huozce/yoloopencvrobot/train29/val_batch2_pred.jpg

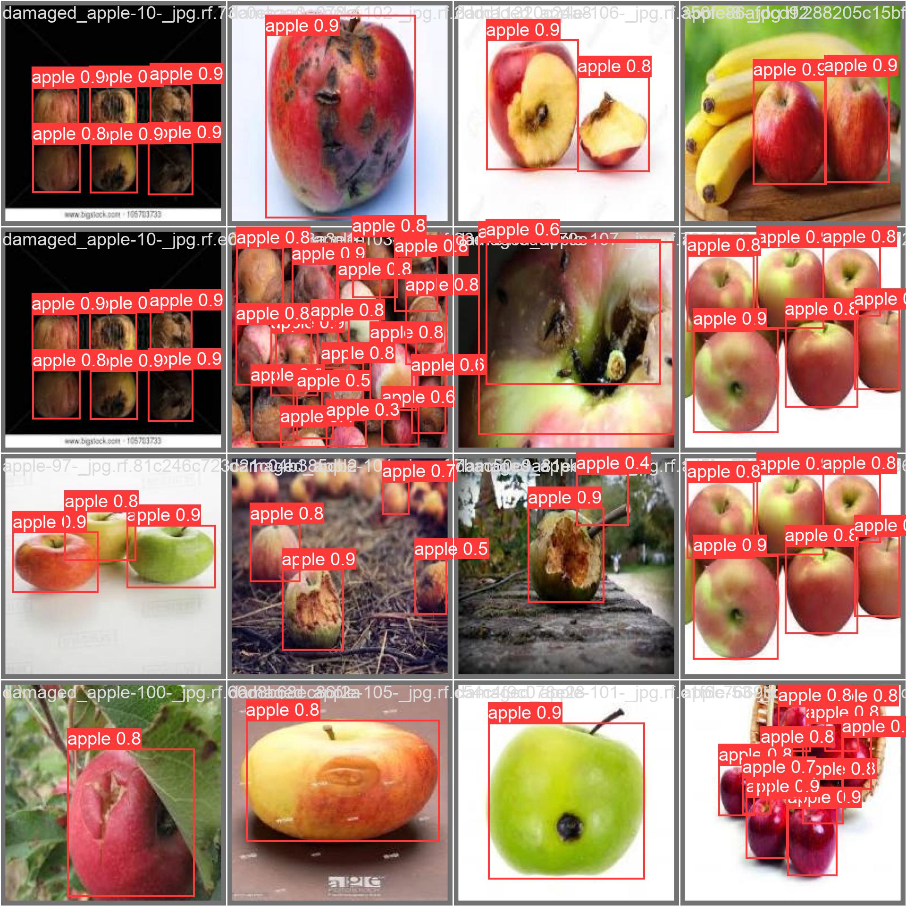
train29/val_batch2_pred.jpg
