huozce/yoloopencvrobot/train29/labels.jpg

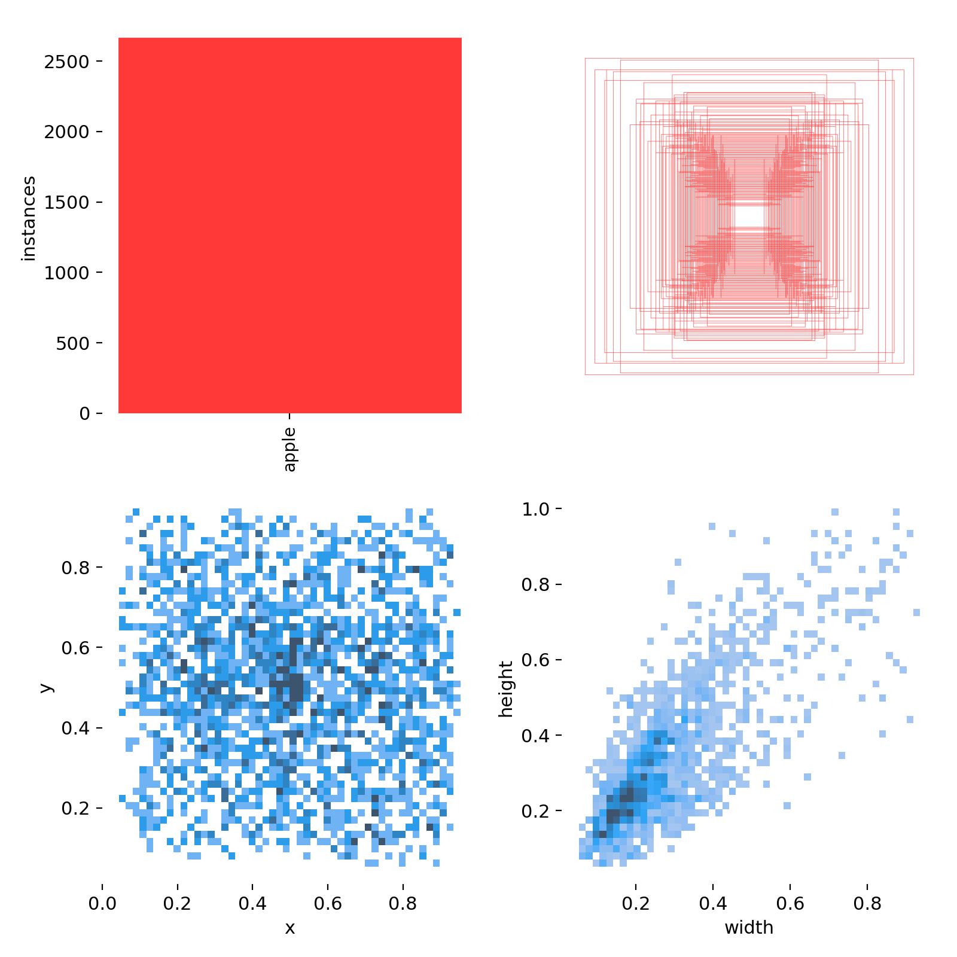
train29/labels.jpg
