huozce/yoloopencvrobot/train29/confusion_matrix.png

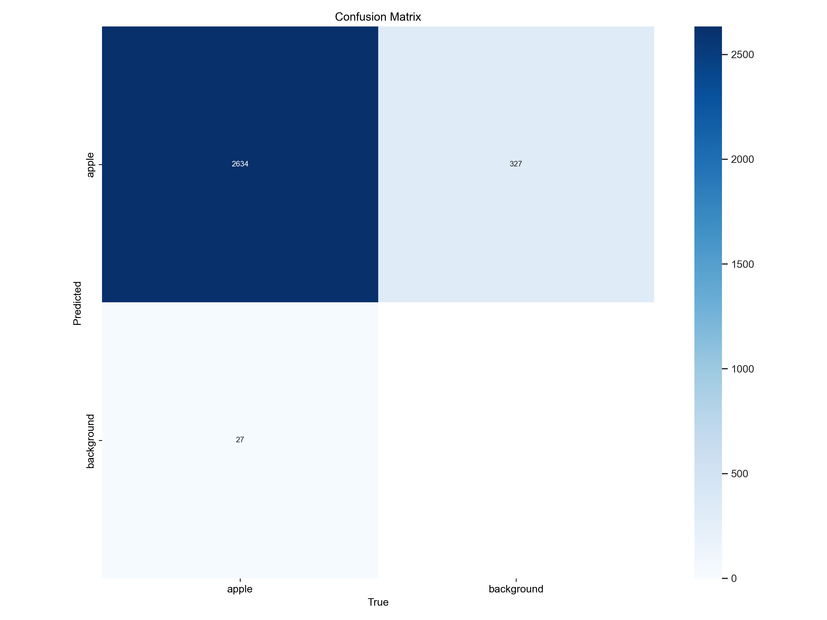
train29/confusion_matrix.png
