huozce/yoloopencvrobot/train29/confusion_matrix_normalized.png

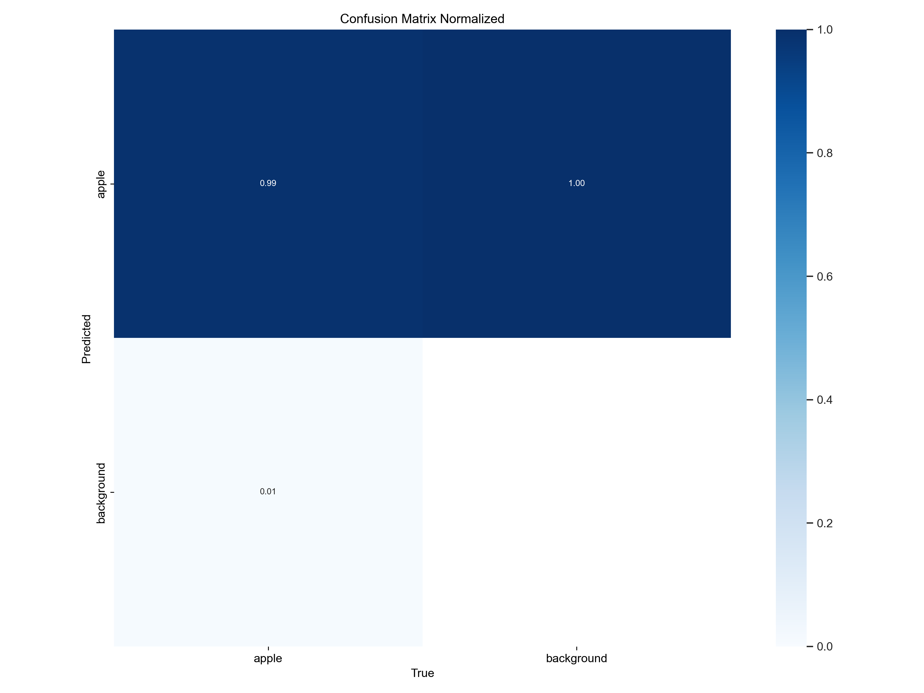
train29/confusion_matrix_normalized.png
