huozce/yoloopencvrobot/train29/F1_curve.png

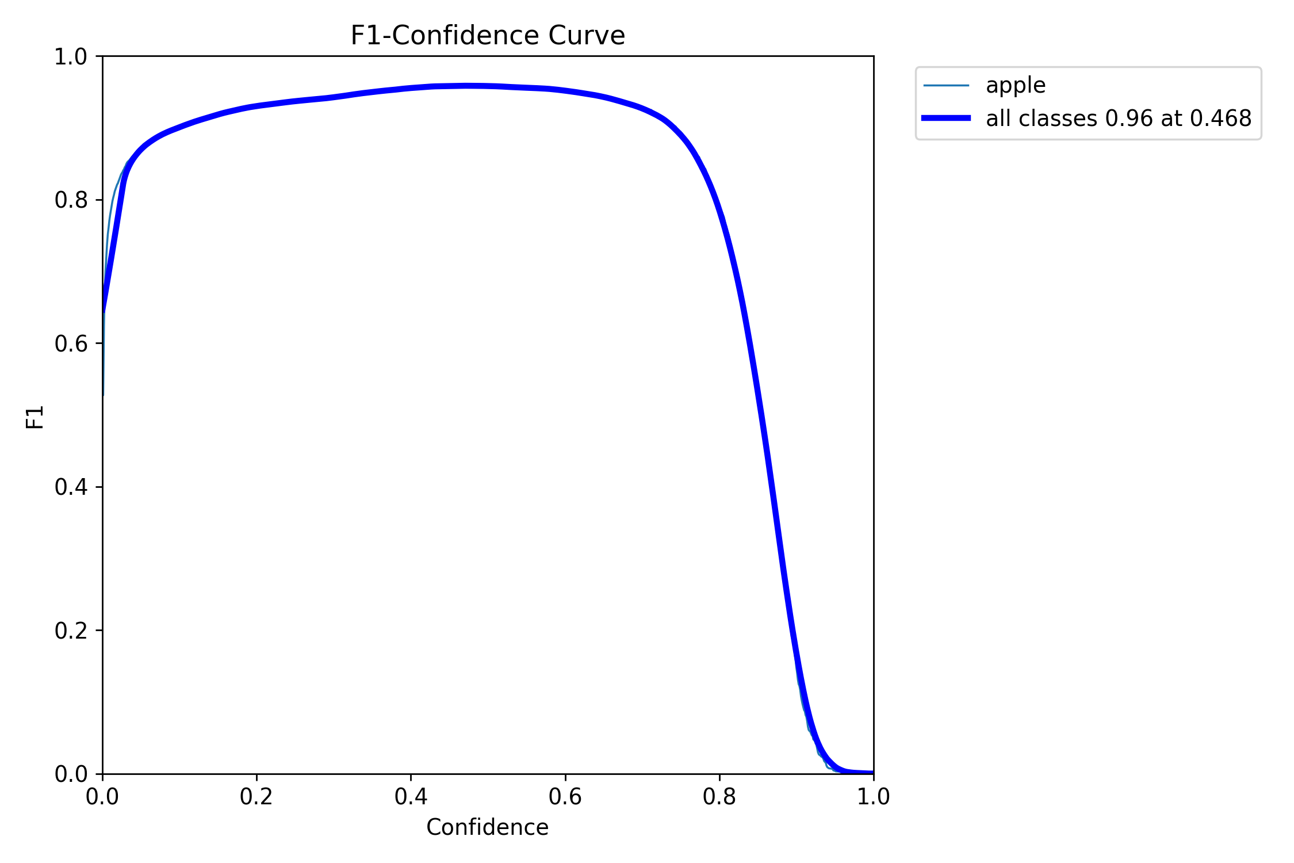
train29/F1_curve.png
