huozce/yoloopencvrobot/train29/labels_correlogram.jpg

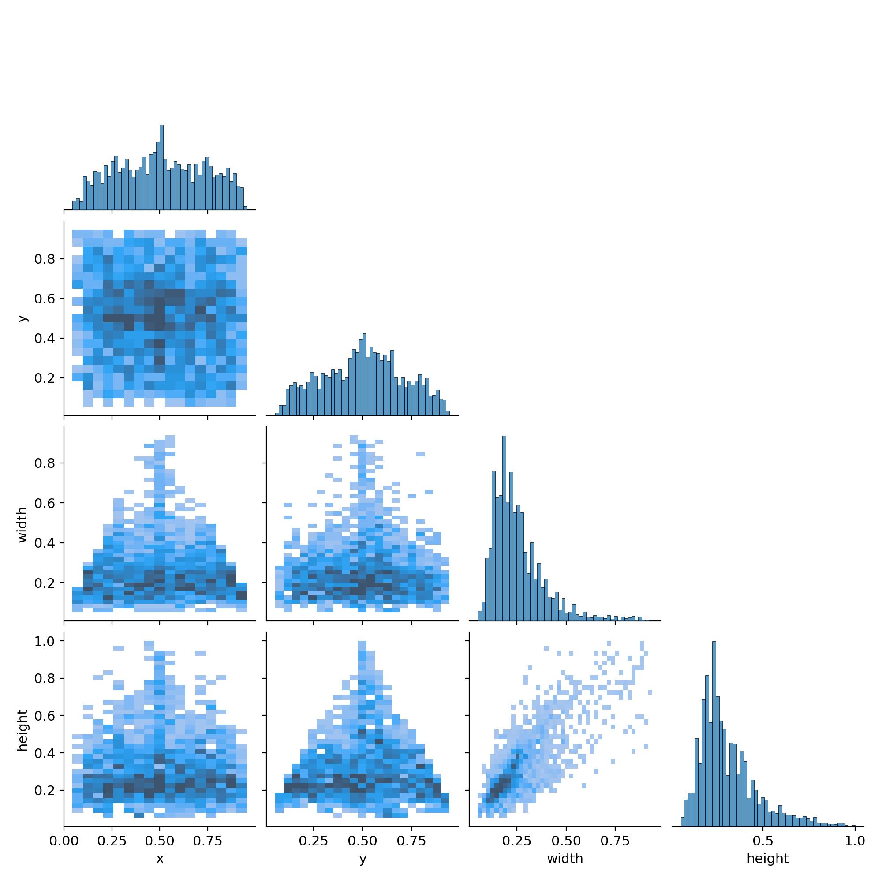
train29/labels_correlogram.jpg
