huozce/yoloopencvrobot/train29/P_curve.png

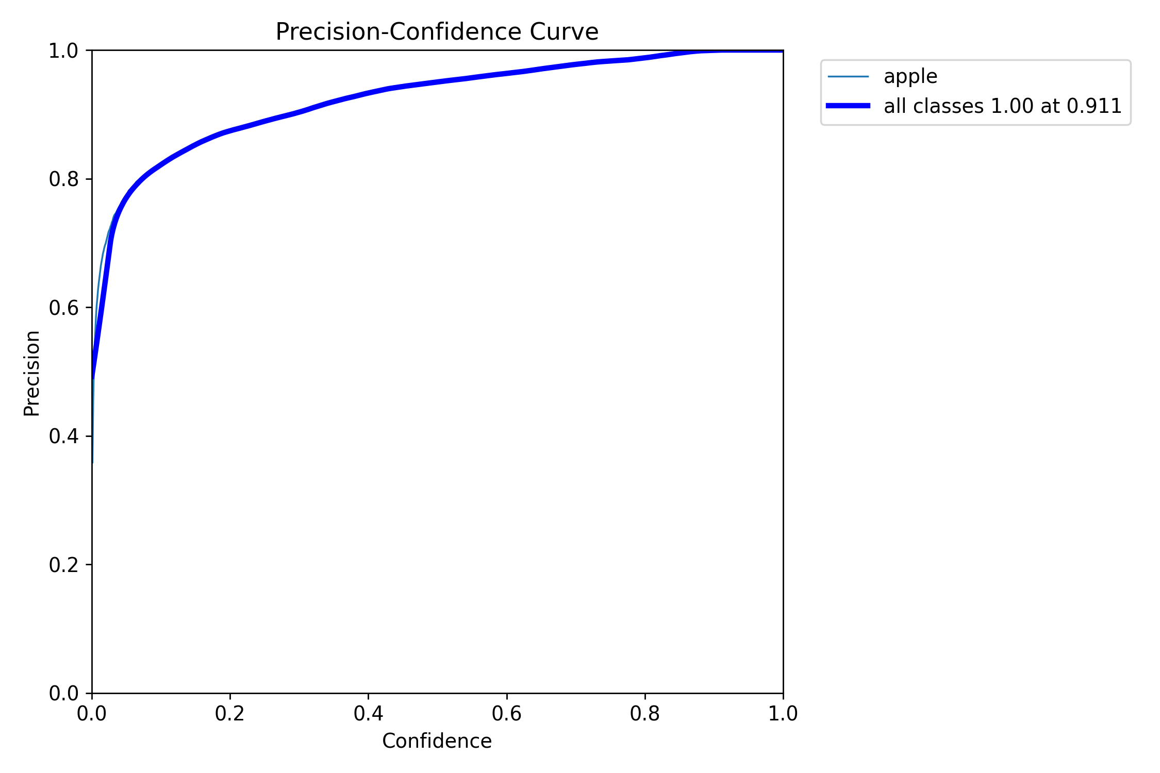
train29/P_curve.png
