huozce/yoloopencvrobot/train29/PR_curve.png

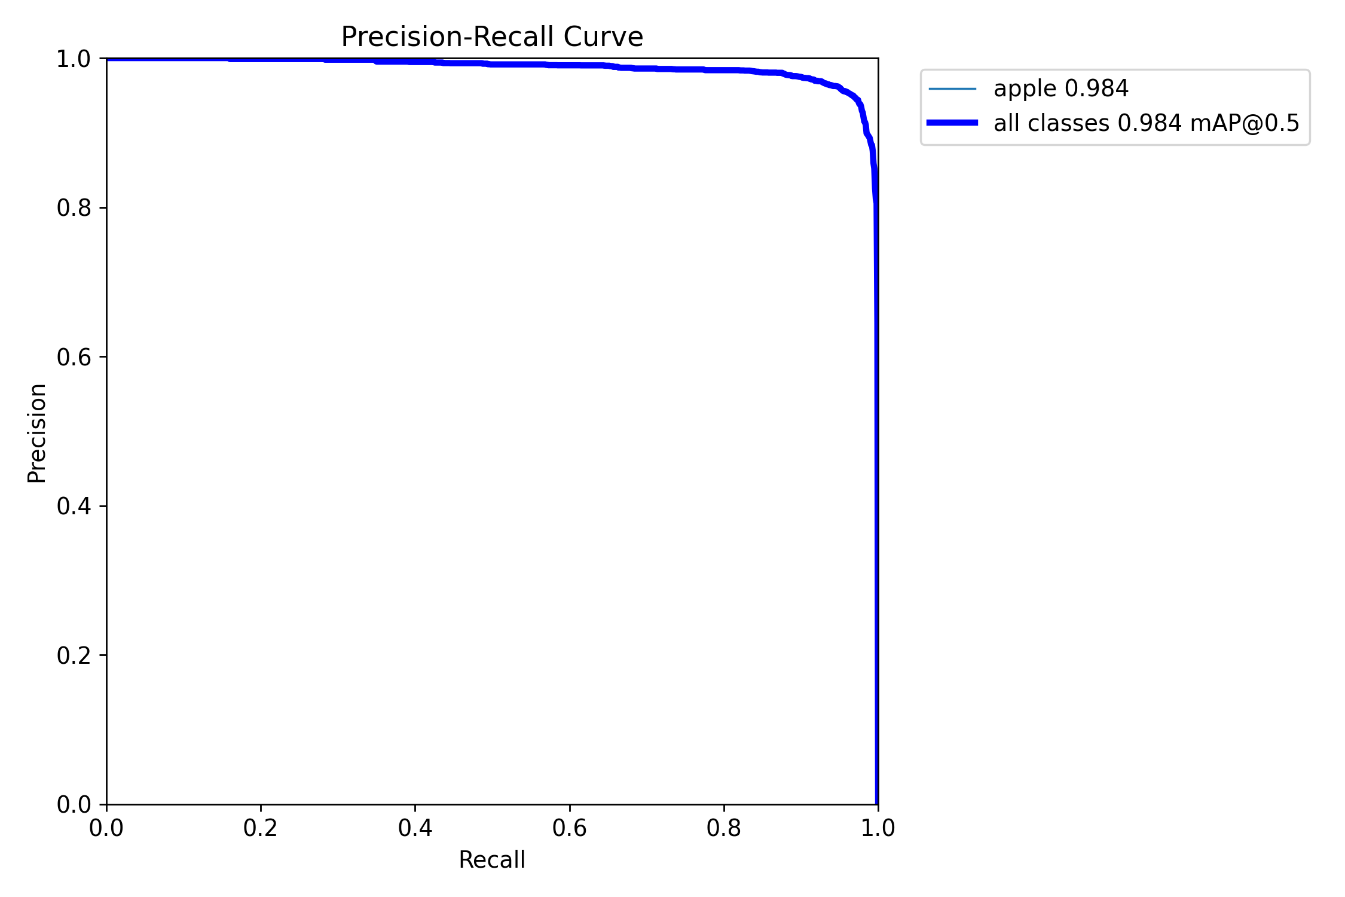
train29/PR_curve.png
