huozce/yoloopencvrobot/train29/train_batch0.jpg

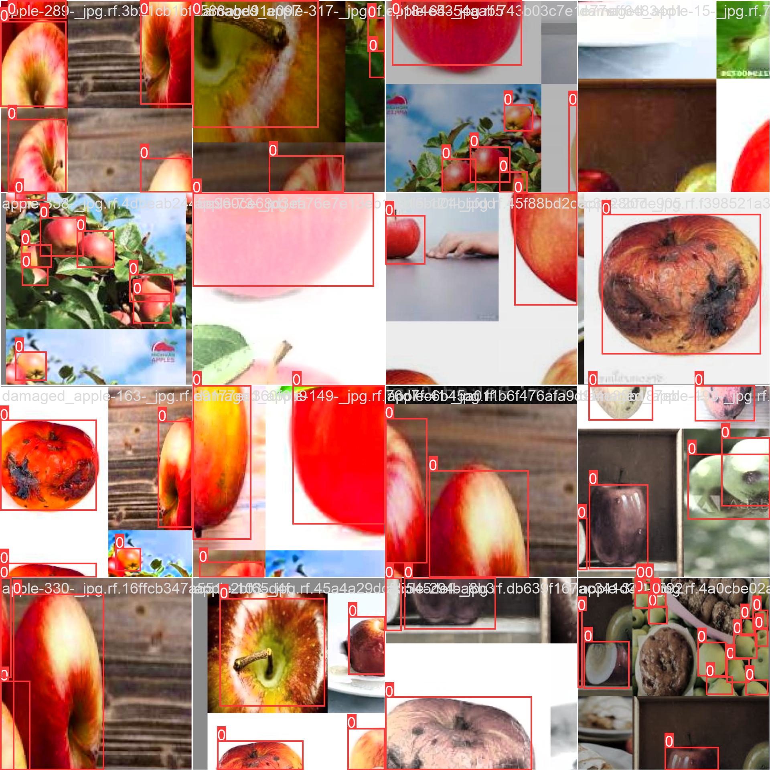
train29/train_batch0.jpg
