huozce/yoloopencvrobot/train29/train_batch1.jpg

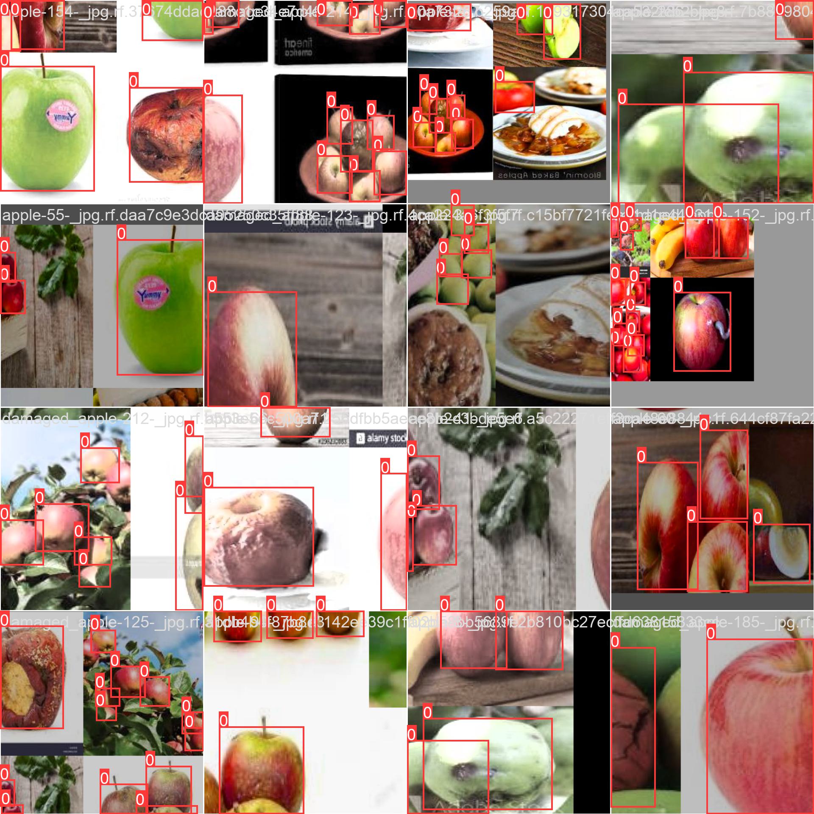
train29/train_batch1.jpg
