huozce/yoloopencvrobot/train29/train_batch2.jpg

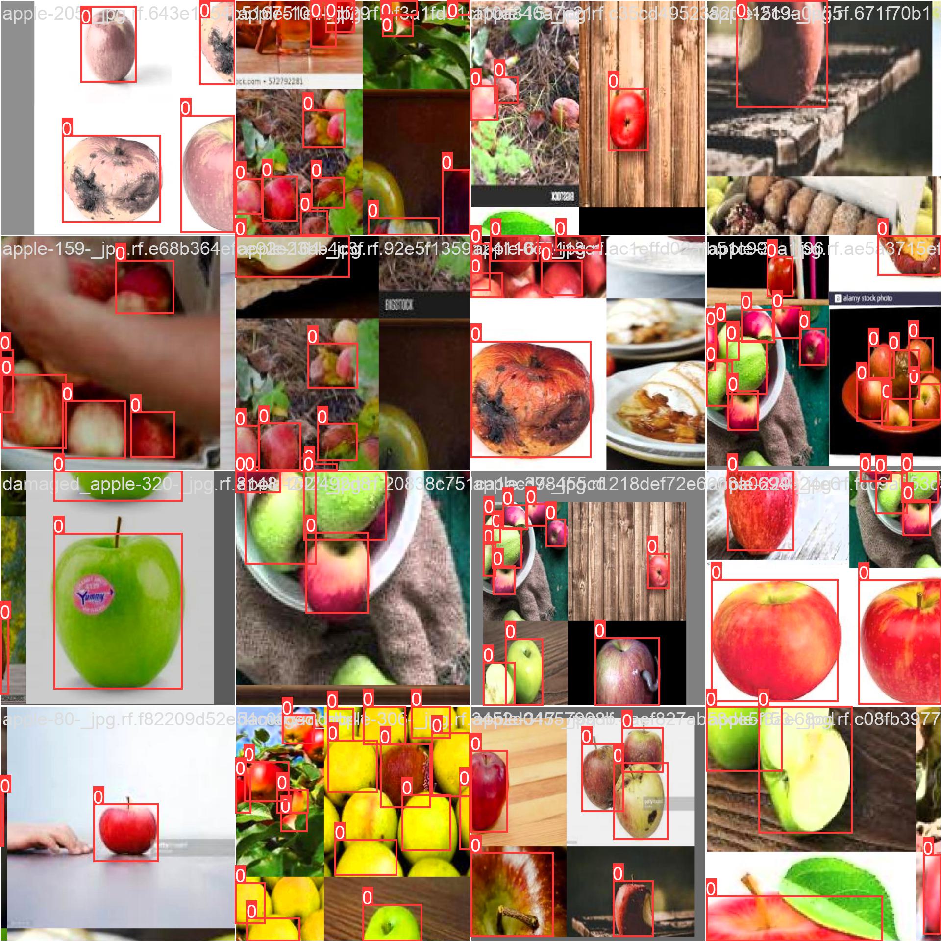
train29/train_batch2.jpg
