huozce/yoloopencvrobot/train29/train_batch5600.jpg

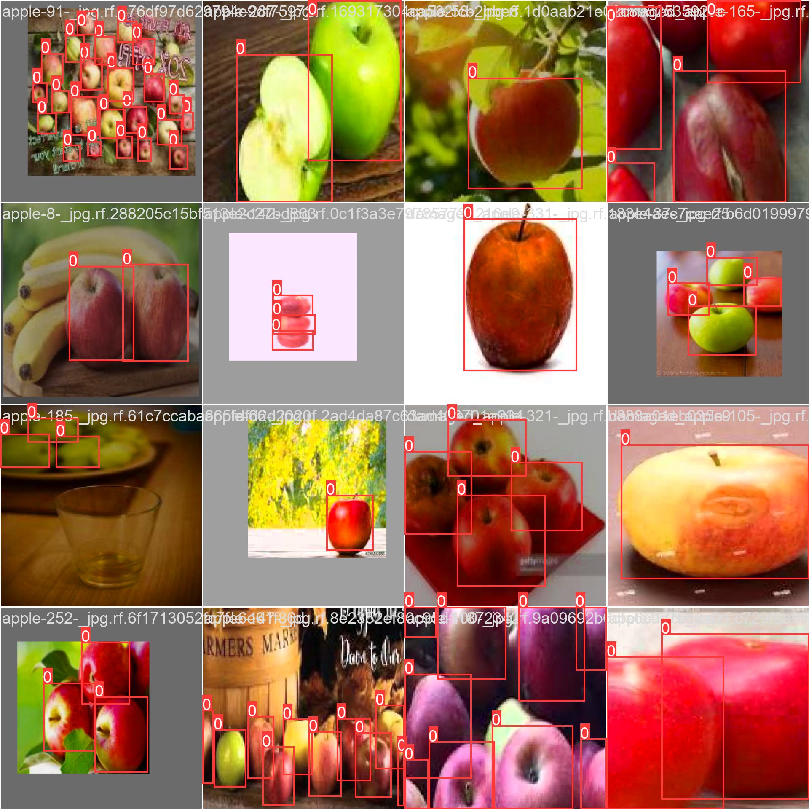
train29/train_batch5600.jpg
