huozce/yoloopencvrobot/train29/train_batch5601.jpg

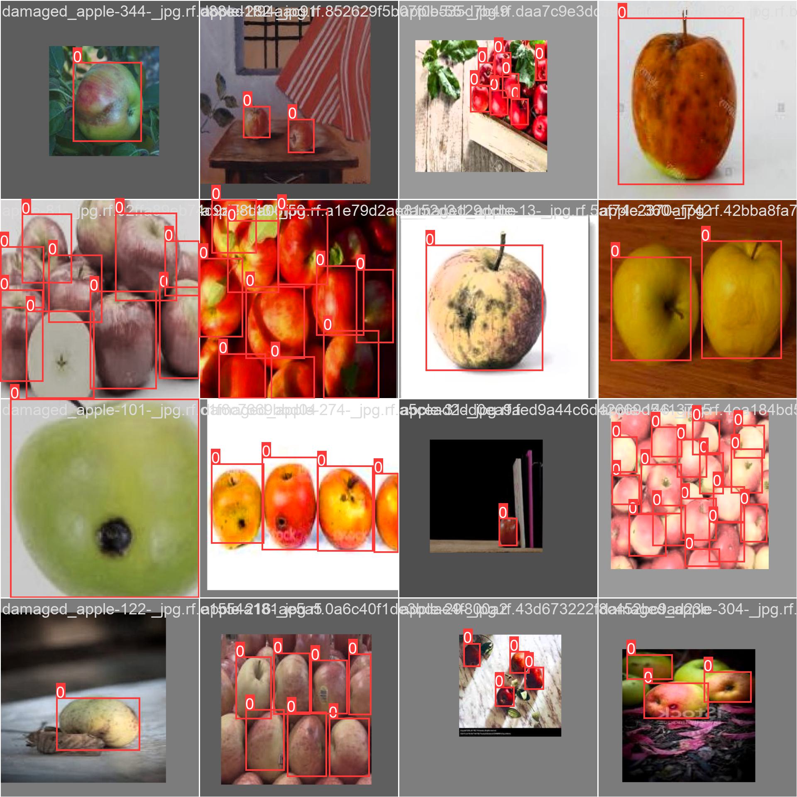
train29/train_batch5601.jpg
