huozce/yoloopencvrobot/train29/train_batch5602.jpg

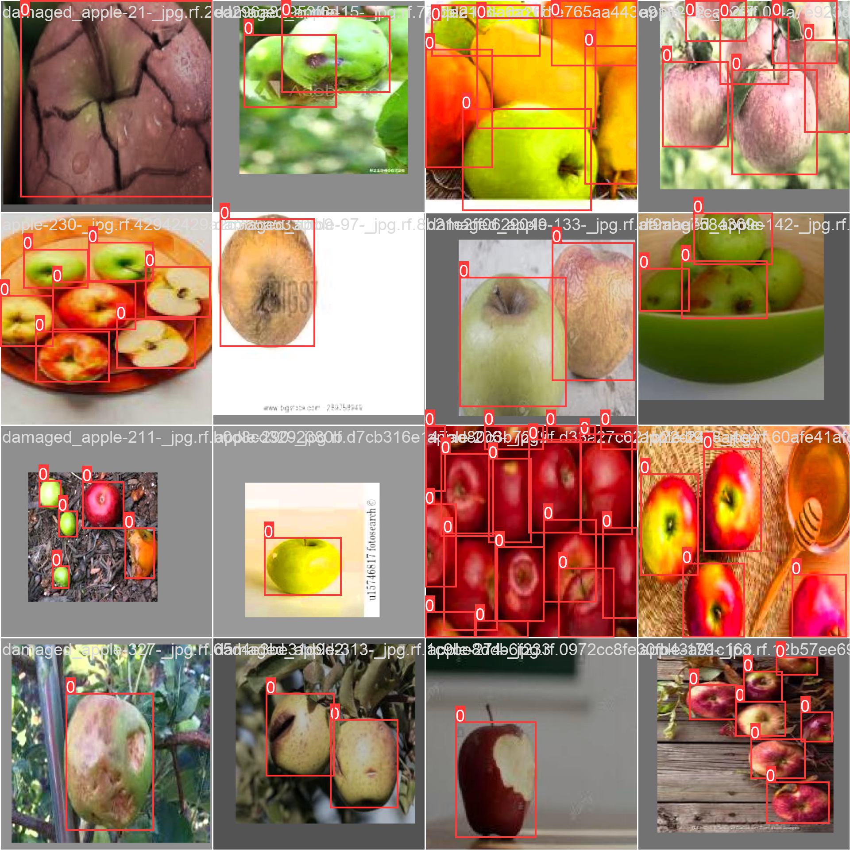
train29/train_batch5602.jpg
