huozce/yoloopencvrobot/train29/val_batch0_labels.jpg

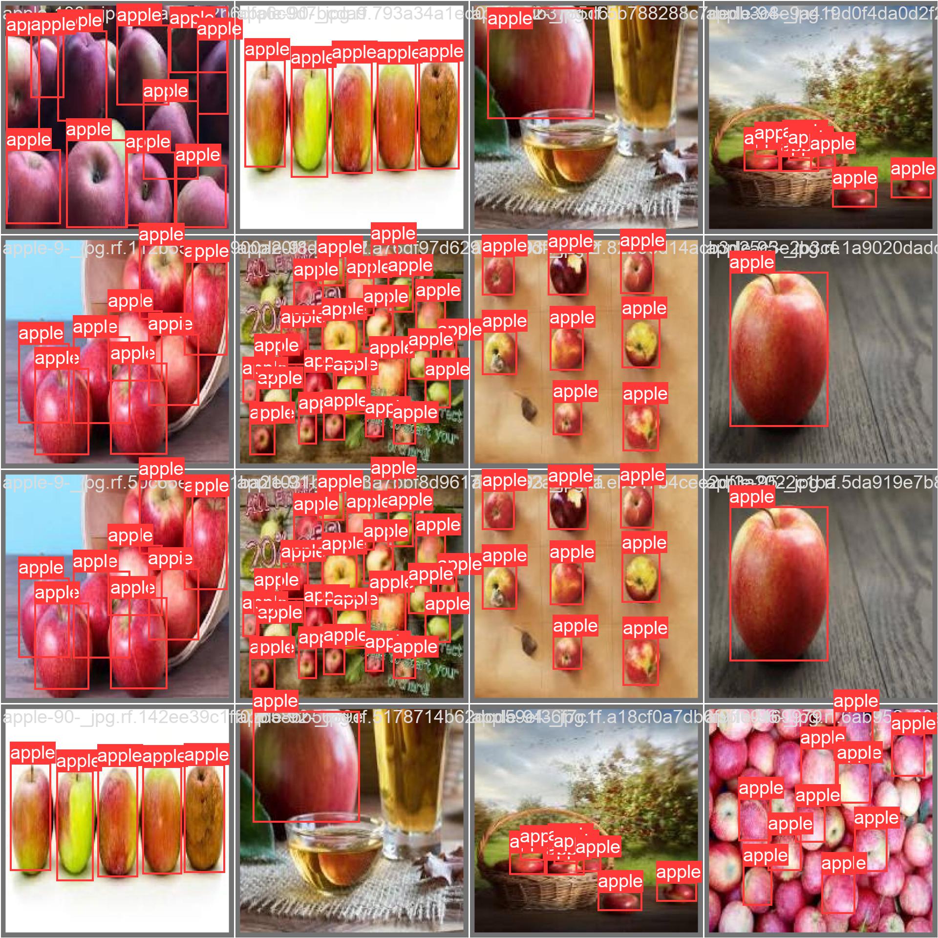
train29/val_batch0_labels.jpg
