huozce/yoloopencvrobot/train29/val_batch1_labels.jpg

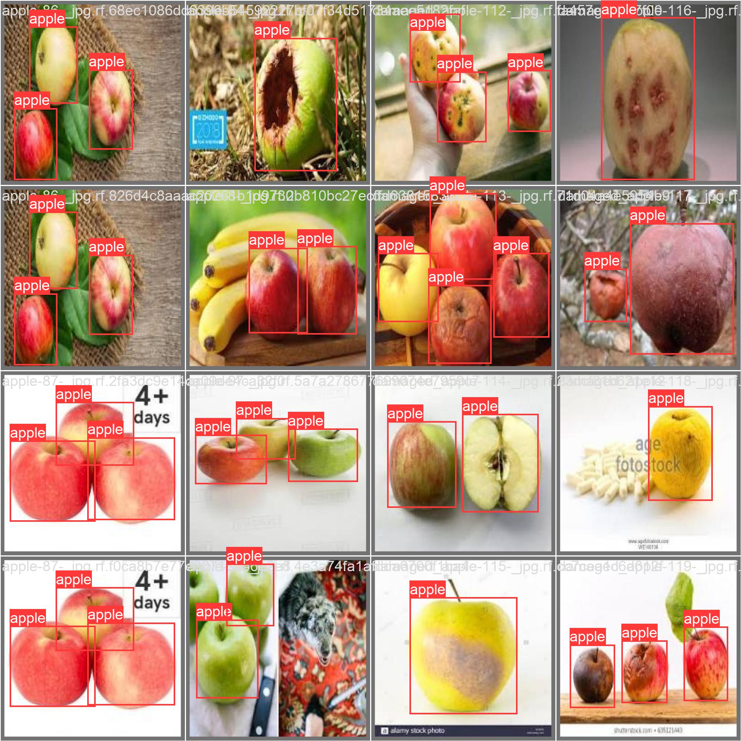
train29/val_batch1_labels.jpg
