huozce/yoloopencvrobot/train29/results.csv

epoch | train/box_loss | train/cls_loss | train/dfl_loss | metrics/precision(B) | metrics/recall(B) | metrics/mAP50(B) | metrics/mAP50-95(B) | val/box_loss | val/cls_loss | val/dfl_loss | lr/pg0 | lr/pg1 | lr/pg2
1 | 3.143 | 3.3373 | 4.0951 | 0.0073 | 0.5171 | 0.02345 | 0.00938 | 2.6643 | 3.5323 | 4.0879 | 0.00065 | 0.00065 | 0.00065
2 | 2.9694 | 2.8667 | 3.6227 | 0.0273 | 0.19917 | 0.01468 | 0.00437 | 2.7626 | 5.6869 | 4.1013 | 0.001308 | 0.001308 | 0.001308
3 | 2.7667 | 2.7672 | 3.3086 | 0.03171 | 0.04961 | 0.0064 | 0.00148 | 3.8068 | 8.1301 | 6.5895 | 0.0019572 | 0.0019572 | 0.0019572
4 | 2.4977 | 2.5348 | 3.0307 | 0.07078 | 0.0357 | 0.01807 | 0.00698 | 3.1273 | 4.1927 | 4.9737 | 0.0019604 | 0.0019604 | 0.0019604
5 | 2.3064 | 2.3466 | 2.808 | 0.38715 | 0.38219 | 0.34397 | 0.1403 | 2.0261 | 4.5454 | 2.7138 | 0.0019604 | 0.0019604 | 0.0019604
6 | 2.0661 | 2.1295 | 2.6103 | 0.47432 | 0.51439 | 0.47145 | 0.20729 | 1.8667 | 3.7314 | 2.6636 | 0.0019472 | 0.0019472 | 0.0019472
7 | 1.955 | 1.9325 | 2.471 | 0.55013 | 0.59226 | 0.56617 | 0.2762 | 1.7161 | 2.1794 | 2.407 | 0.001934 | 0.001934 | 0.001934
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
