huozce/yoloopencvrobot/train29/results.png

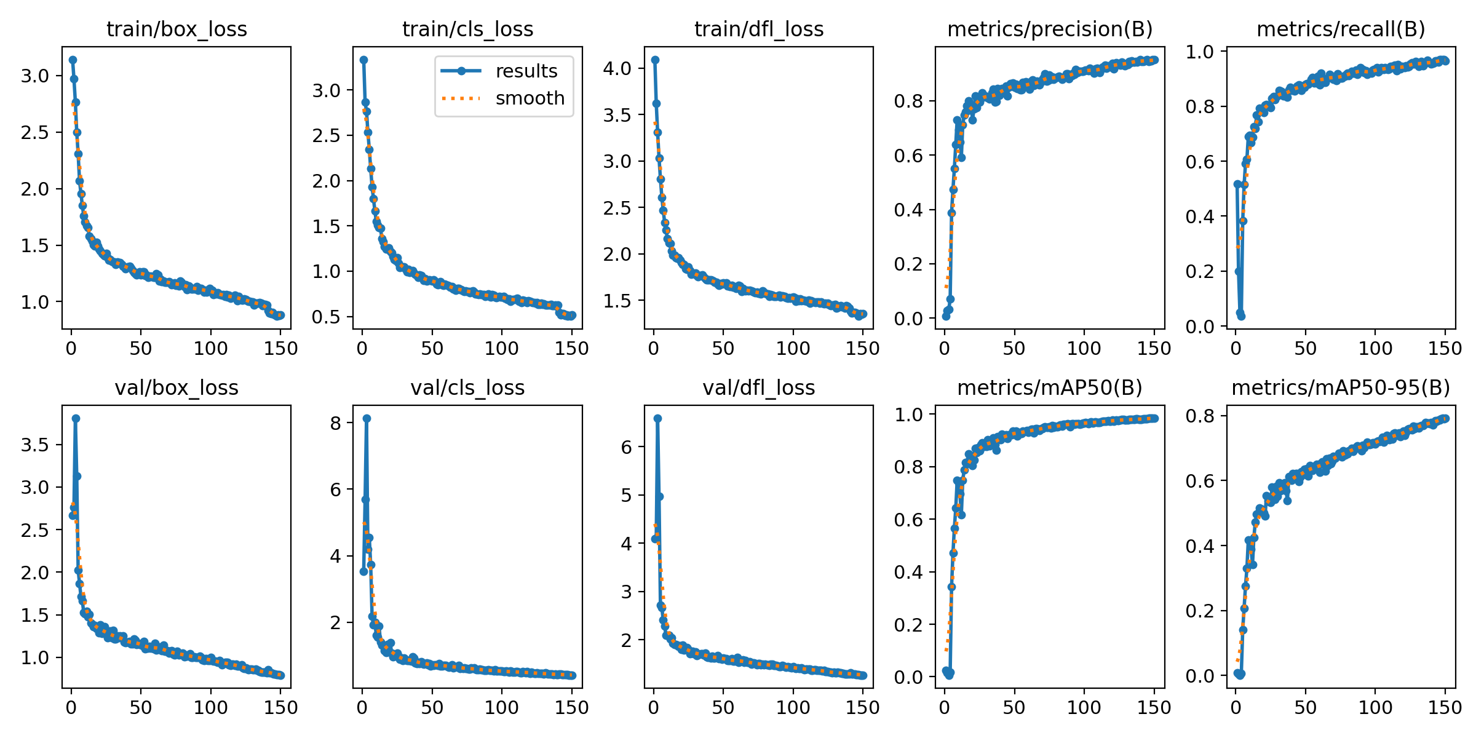
train29/results.png
